AzJester/passive_sensor_demo_F5.2/docs/images/demo/hardware_exploded.png

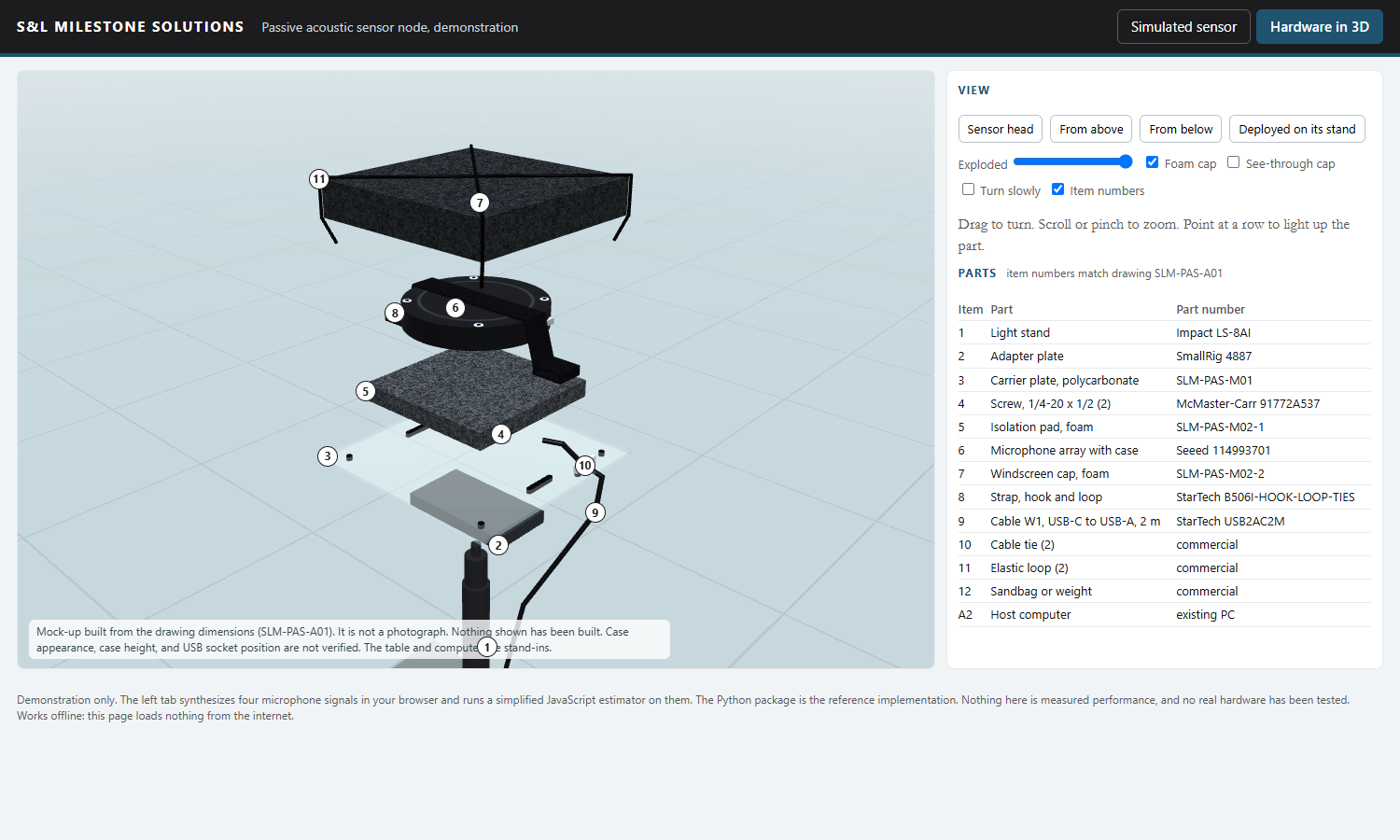
docs/images/demo/hardware_exploded.png
