AzJester/passive_sensor_demo_F5.2/docs/images/demo/hardware_from_above.png

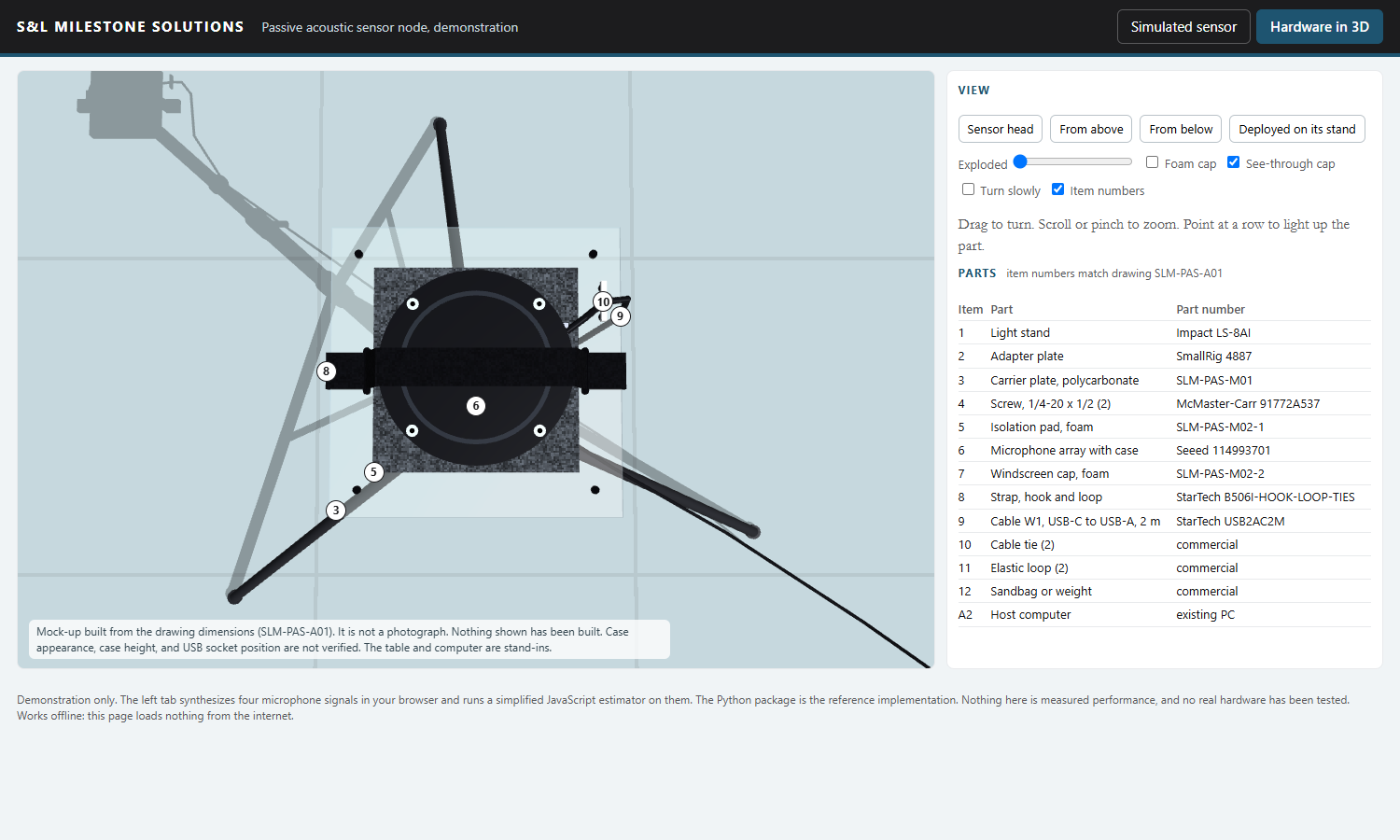
docs/images/demo/hardware_from_above.png
