AzJester/passive_sensor_demo_F5.2/docs/images/demo/sensor_false_alert_source.png

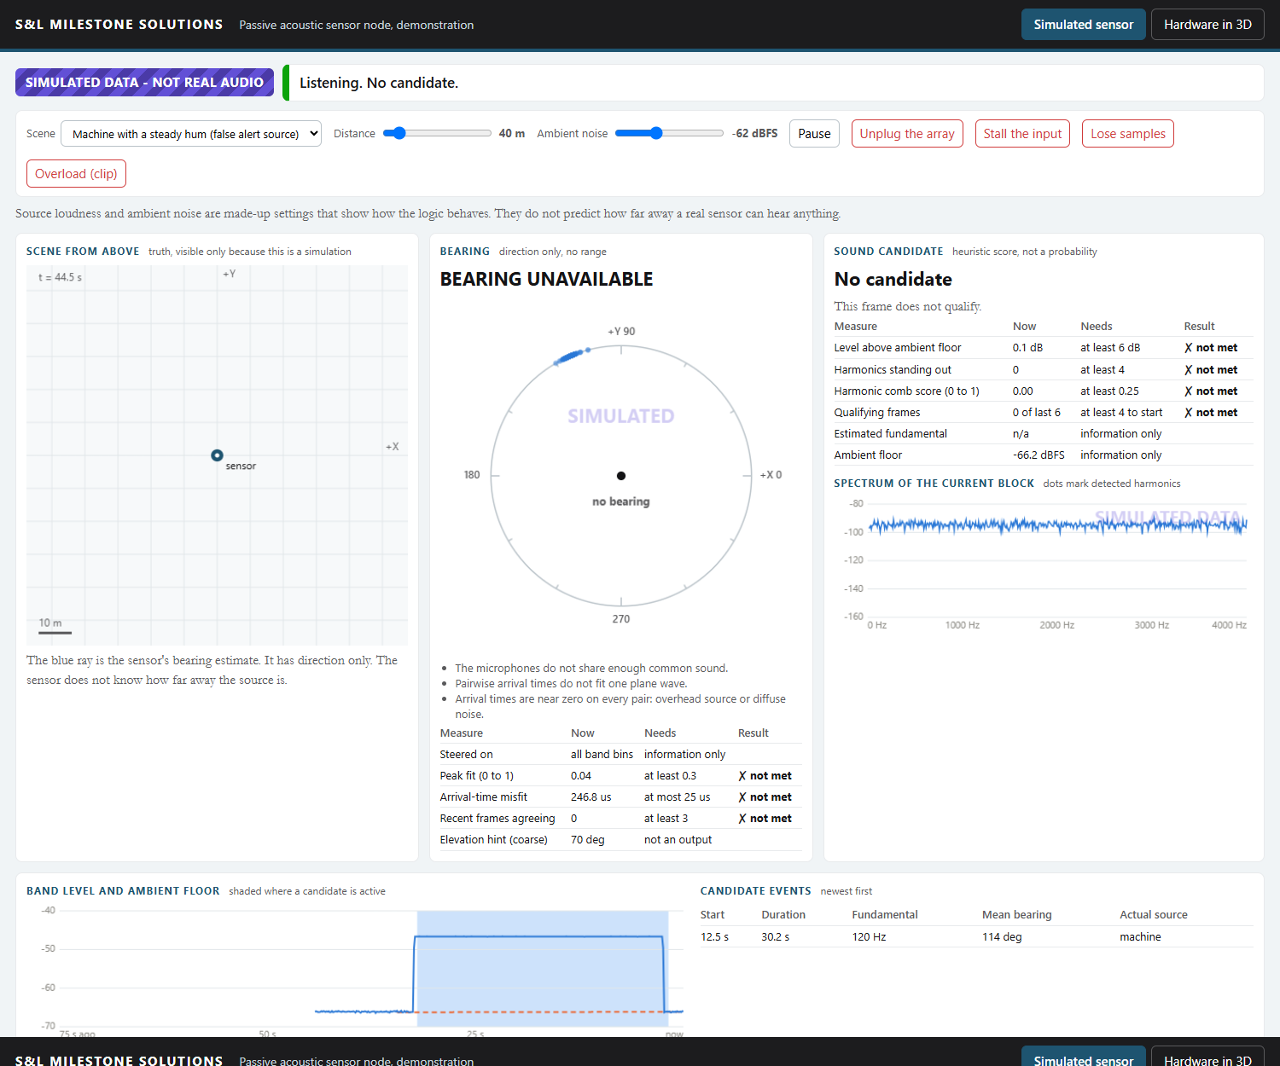
docs/images/demo/sensor_false_alert_source.png
