AzJester/passive_sensor_demo_F5.2/docs/images/demo/sensor_input_stale.png

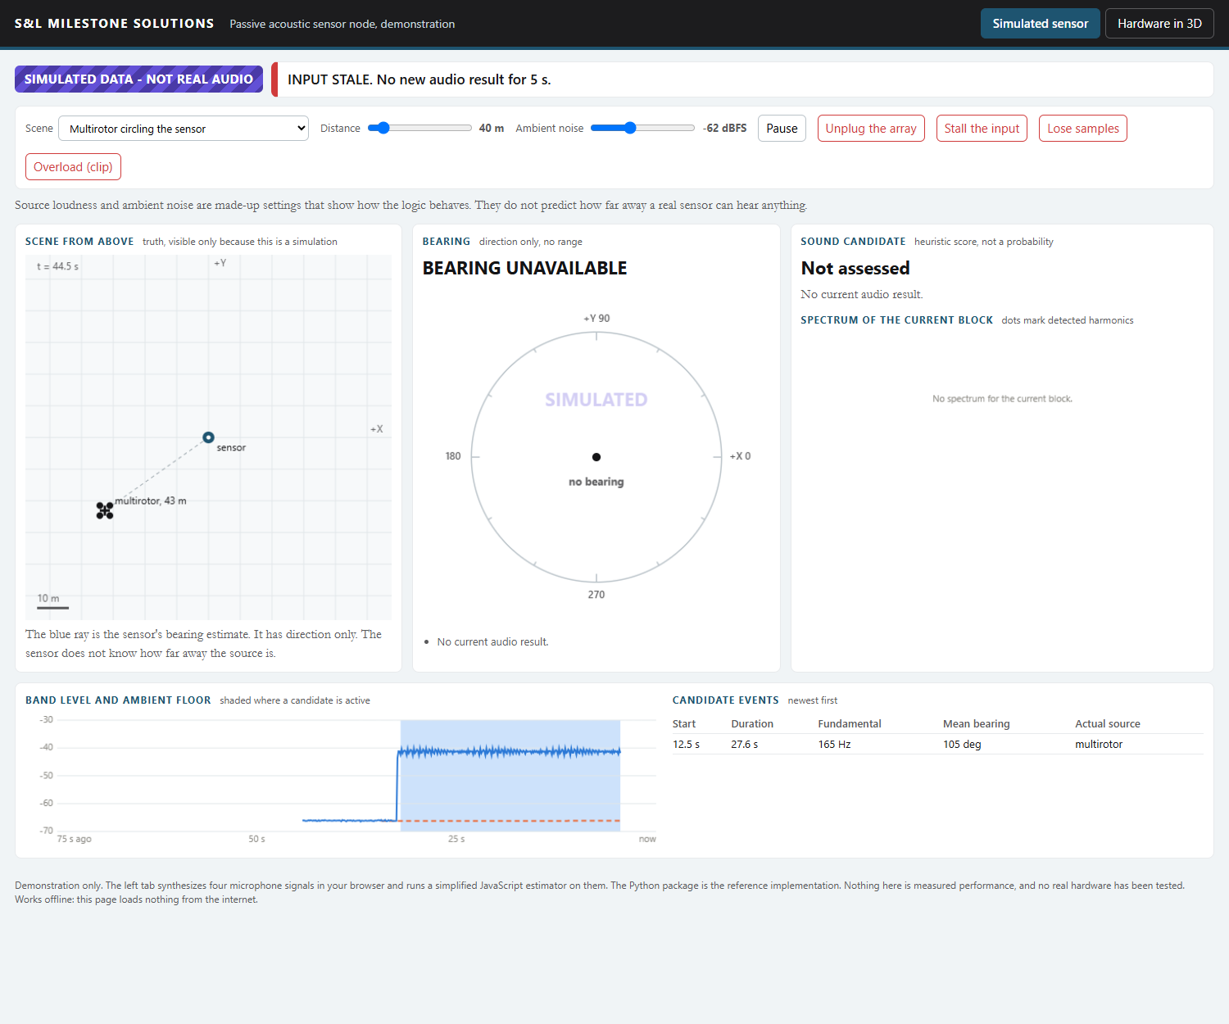
docs/images/demo/sensor_input_stale.png
