AzJester/passive_sensor_demo_F5.2/docs/images/demo/sensor_tone_rejected.png

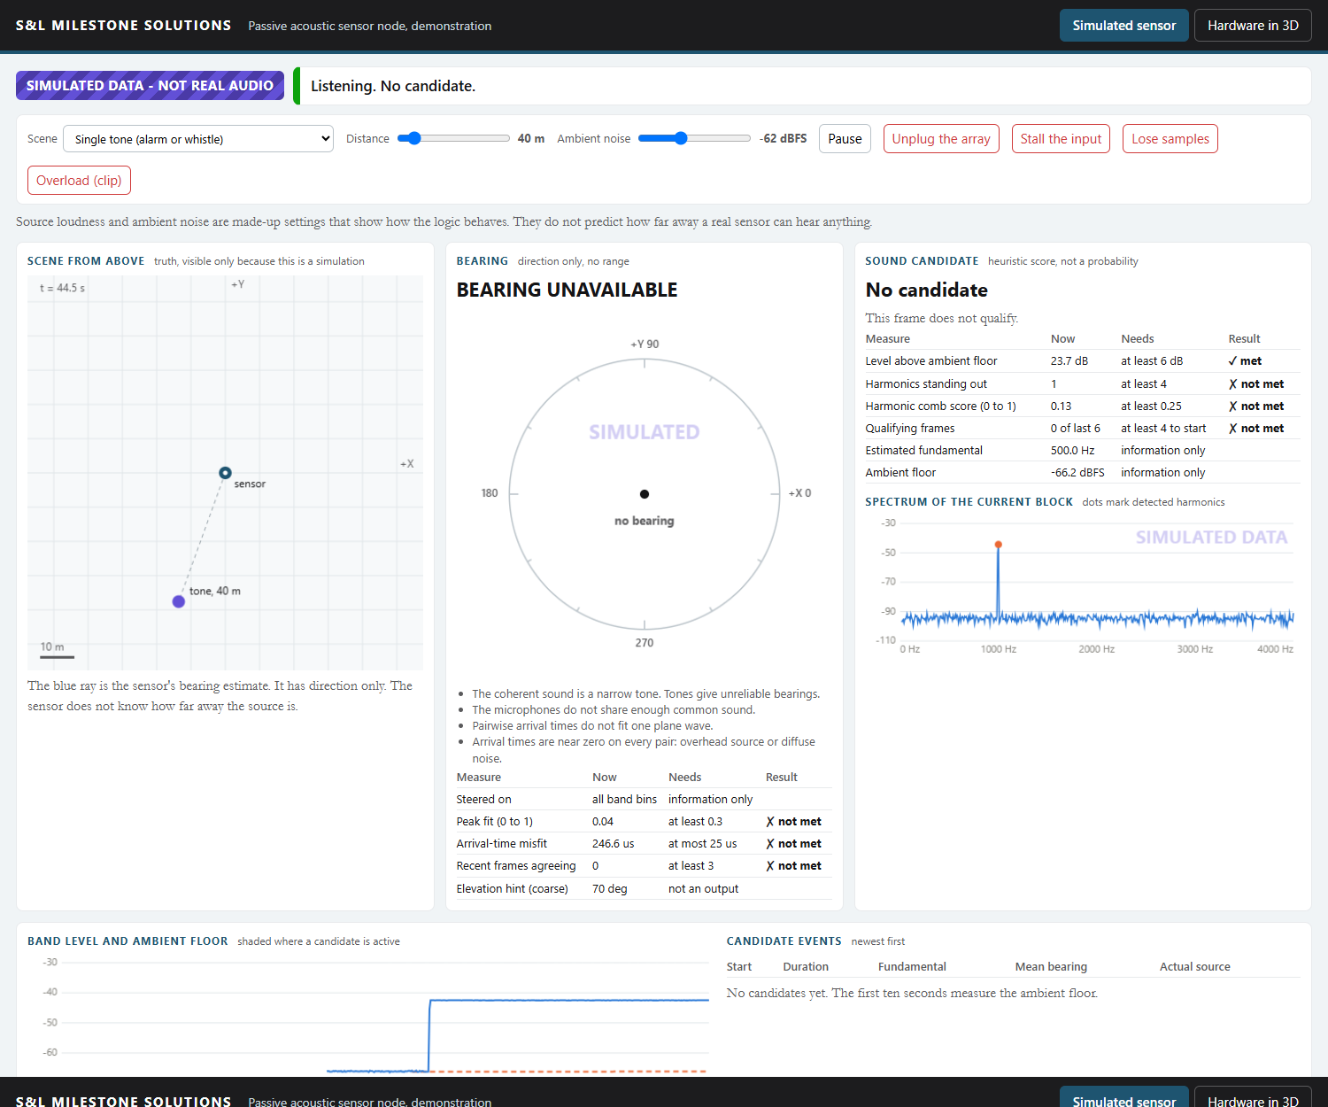
docs/images/demo/sensor_tone_rejected.png
