AzJester/passive_sensor_demo_F5.2/hardware/bom.csv

ref | group | item | manufacturer | part_number | quantity | unit_price_usd | price_seen | price_date | source | url | note
A1 | required | USB four-microphone array with case | Seeed Studio | 114993701 | 1 | 59.90 | page | 2026-11-09 | Seeed Studio | https://www.seeedstudio.com/ReSpeaker-XVF3800-USB-4-Mic-Array-With-Case-p-6490.html | China warehouse in stock; US on back order; Mouser 713-114993701
W1 | required | USB 2.0 cable, USB-C to USB-A, 2 m | StarTech | USB2AC2M | 1 | 20.49 | page | 2026-11-09 | StarTech | https://www.startech.com/en-us/cables/usb2ac2m | USB-C host: USB2CC1M
P1 | required | Clear polycarbonate sheet, 12 x 12 x 1/8 in | McMaster-Carr | 8574K26 | 1 | 10.42 | page | 2026-11-09 | McMaster-Carr | https://www.mcmaster.com/8574K26/ | carrier plate M01
M1 | required | Tripod adapter plate with 1/4 in-20 threads | SmallRig | 4887 | 1 | 12.99 | page | 2026-11-09 | B&H | https://www.bhphotovideo.com/c/product/1852171-REG/smallrig_4887_multifunctional_cheese_mount_plate.html | hole spacing not verified
M2 | required | Screw 1/4 in-20 x 1/2 in, 18-8, pack of 50 | McMaster-Carr | 91772A537 | 1 | 14.80 | page | 2026-11-09 | McMaster-Carr | https://www.mcmaster.com/91772A537/ | 2 used
M3 | required | Light stand with 1/4 in-20 stud | Impact | LS-8AI | 1 | 32.95 | page | 2026-11-09 | B&H | https://www.bhphotovideo.com/c/product/1258466-REG/impact_ls_8ai_air_cushioned_light_stand_black.html | weight the base
M4 | required | Hook-and-loop ties, 6 in, pack of 50 | StarTech | B506I-HOOK-LOOP-TIES | 1 | 19.46 | page | 2026-11-09 | StarTech | https://www.startech.com/en-us/cables/b506i-hook-loop-ties | join three end to end
M5 | required | Reticulated polyurethane foam, 30 PPI, 1 in x 36 x 48 in | The Foam Factory | no SKU shown | 1 | 24.99 | page | 2026-11-09 | The Foam Factory | https://www.thefoamfactory.com/opencellfoam/filter.html | windscreen cap
M6 | required | Reticulated polyurethane foam, 30 PPI, 1/2 in x 36 x 48 in | The Foam Factory | no SKU shown | 1 | 12.99 | page | 2026-11-09 | The Foam Factory | https://www.thefoamfactory.com/opencellfoam/filter.html | isolation pad
F1 | optional | Snap-on ferrite, 6.6 mm bore | Fair-Rite | 0431164281 | 1 | 2.83 | page | 2026-11-09 | Digi-Key | https://www.digikey.com/en/products/detail/fair-rite-products-corp/0431164281/8594000 | only if interference is seen
M7 | optional | Screw M4 x 20, pan head, 18-8, pack of 100 | McMaster-Carr | 92000A228 | 1 | 14.76 | page | 2026-11-09 | McMaster-Carr | https://www.mcmaster.com/92000A228/ | corner holes
M8 | optional | Locknut M4, nylon insert, 18-8, pack of 100 | McMaster-Carr | 93625A150 | 1 | 7.03 | page | 2026-11-09 | McMaster-Carr | https://www.mcmaster.com/93625A150/ | corner holes
M9 | optional | Washer M4, 18-8, pack of 100 | McMaster-Carr | 93475A230 | 1 | 3.93 | page | 2026-11-09 | McMaster-Carr | https://www.mcmaster.com/93475A230/ | corner holes
M10 | optional | Adhesive cable-tie mount, 1 x 1 in | Panduit | ABM2S-A-C | 2 | 1.07 | search excerpt | 2026-11-09 | Gordon Electric Supply | https://www.gordonelectricsupply.com/p/Panduit-Abm2S-A-C-Cable-Tie-Mount-Adh-1Inxi1In-Wh-Pk100/6750617 | strain relief on the stand
T1 | test equipment | Battery loudspeaker | JBL | JBLGO5BLUAM | 1 | 54.95 | page | 2026-11-09 | B&H | https://www.bhphotovideo.com/c/product/1808908-REG/jbl_jblgo4bluam_go_4_portable_bluetooth.html | broadband test source
T2 | test equipment | Tape measure, 100 ft, open reel | Komelon | 6611 | 1 | 25.67 | search excerpt | 2026-11-09 | Hanes Supply | https://www.hanessupply.com/hand-tools/testing-and-measuring/komelon-6611 | positions
T3 | test equipment | Thermometer and hygrometer | ThermoPro | TP50 | 1 | 15.99 | search excerpt | 2026-11-09 | TempPro | https://temppro.com/products/tp50-digital-indoor-hygrometer-thermometer | air temperature
T4 | test equipment | Sound level meter | Galaxy Audio | CM-130 | 1 | 74.99 | page | 2026-11-09 | B&H | https://www.bhphotovideo.com/c/product/333306-REG/Galaxy_Audio_CM_130_CM_130_CHECK_MATE.html | optional
