AzJester/passive_sensor_demo_F5.2/hardware/cad/carrier.dxf

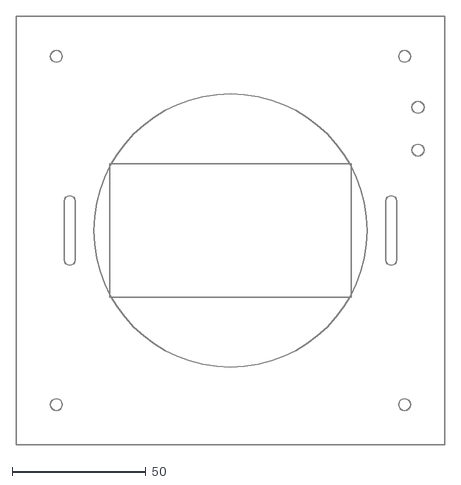
[picture p13: CAD file, 2026-11-10]
hardware/cad/carrier.dxf
160.0 x 160.0
