AzJester/passive_sensor_demo_F5.2/hardware/cad/carrier.scad

// Carrier plate SLM-PAS-M01, revision A, 2026-11-10. Millimetres. Generated by hardware/make_cad.py.
// S&L Milestone Solutions. Preliminary: not cut or fitted. Measure the purchased case before cutting.
$fn = 64;
plate_side = 160.0;
plate_thickness = 3.0;

module slot(x, y, w, len) {
    hull() {
        translate([x, y - (len - w) / 2, -1]) cylinder(h = plate_thickness + 2, d = w);
        translate([x, y + (len - w) / 2, -1]) cylinder(h = plate_thickness + 2, d = w);
    }
}

difference() {
    cube([plate_side, plate_side, plate_thickness]);
    translate([15.0, 15.0, -1]) cylinder(h = plate_thickness + 2, d = 4.5);
    translate([145.0, 15.0, -1]) cylinder(h = plate_thickness + 2, d = 4.5);
    translate([15.0, 145.0, -1]) cylinder(h = plate_thickness + 2, d = 4.5);
    translate([145.0, 145.0, -1]) cylinder(h = plate_thickness + 2, d = 4.5);
    translate([150.0, 110.0, -1]) cylinder(h = plate_thickness + 2, d = 4.5);
    translate([150.0, 126.0, -1]) cylinder(h = plate_thickness + 2, d = 4.5);
    slot(20.0, 80.0, 4.0, 26.0);
    slot(140.0, 80.0, 4.0, 26.0);
}

// Reference only: listed case outline. Remove before export.
%translate([plate_side / 2, plate_side / 2, plate_thickness + 10]) cylinder(h = 10, d = 102.0);
