AzJester/passive_sensor_demo_F5.2/hardware/drawings/SLM-PAS-A01.pdf

## TOP VIEW

6

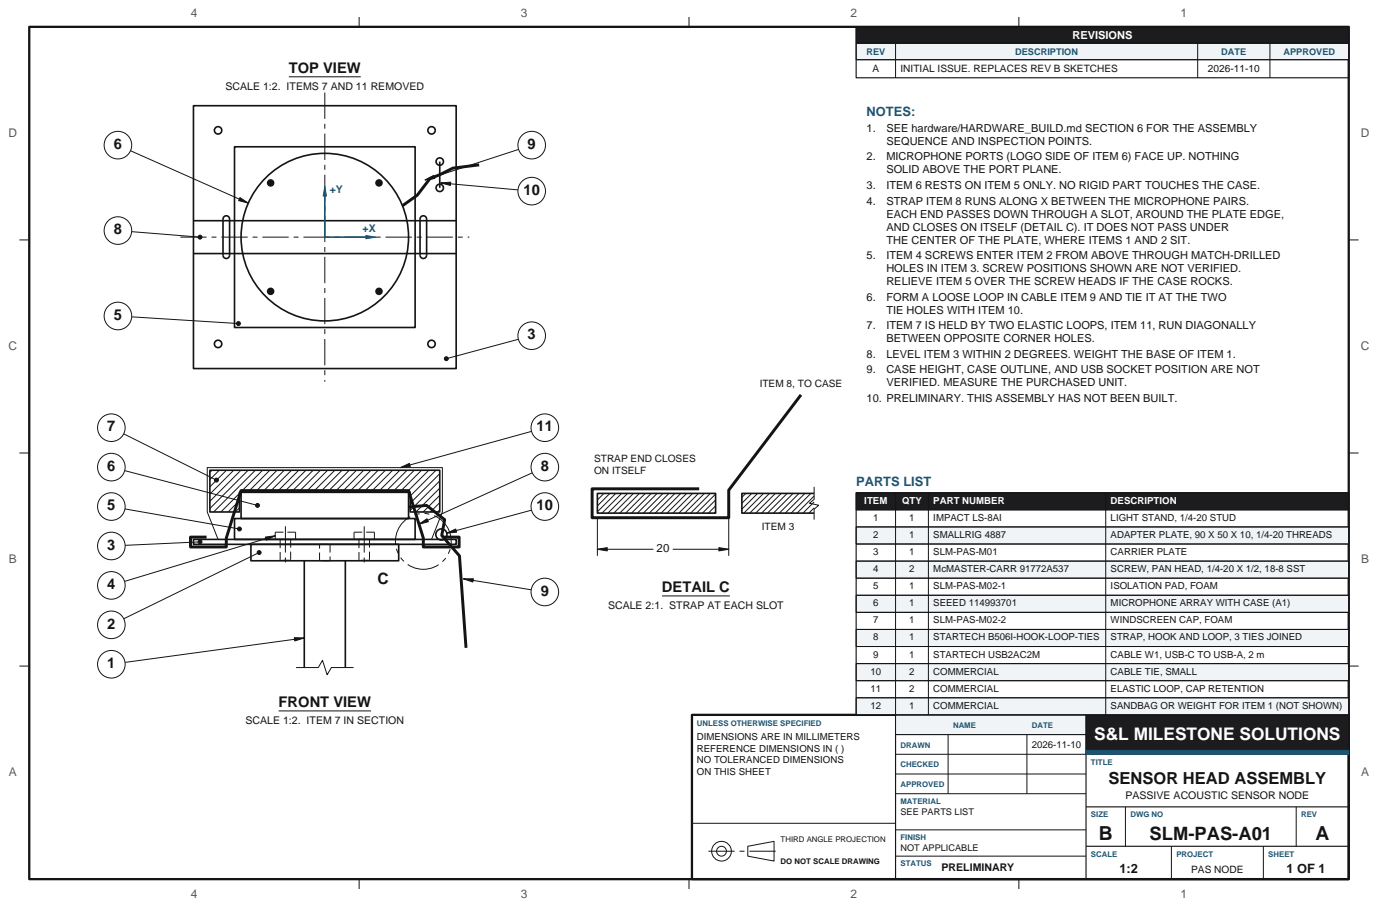
[picture p16: page 1]
REVISIONS; REV; DESCRIPTION; DATE; APPROVED; INITIAL ISSUE. REPLACES REV B SKETCHES; NAME; FINISH NOT APPLICABLE STATUS PRELIMINARY; S&L MILESTONE SOLUTIONS; SIZE; DWG NO; REV A; SCALE; PROJECT PAS NODE; SHEET 1 OF 1; ITEM 3; DETAIL C; PARTS LIST; ITEM; QTY; PART NUMBER; IMPACT LS-8AI; LIGHT STAND, 1/4-20 STUD; SMALLRIG 4887; ADAPTER PLATE, 90 X 50 X 10, 1/4-20 THREADS; SLM-PAS-M01; CARRIER PLATE; McMASTER-CARR 91772A537; SCREW, PAN HEAD, 1/4-20 X 1/2, 18-8 SST; SLM-PAS-M02-1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

SCALE 1:2. ITEMS 7 AND 11 REMOVED

NOTES:
1. SEE hardware/HARDWARE_BUILD.md SECTION 6 FOR THE ASSEMBLY
SEQUENCE AND INSPECTION POINTS.
2. MICROPHONE PORTS (LOGO SIDE OF ITEM 6) FACE UP. NOTHING
SOLID ABOVE THE PORT PLANE.
3. ITEM 6 RESTS ON ITEM 5 ONLY. NO RIGID PART TOUCHES THE CASE.
4. STRAP ITEM 8 RUNS ALONG X BETWEEN THE MICROPHONE PAIRS.
EACH END PASSES DOWN THROUGH A SLOT, AROUND THE PLATE EDGE,
AND CLOSES ON ITSELF (DETAIL C). IT DOES NOT PASS UNDER
THE CENTER OF THE PLATE, WHERE ITEMS 1 AND 2 SIT.
5. ITEM 4 SCREWS ENTER ITEM 2 FROM ABOVE THROUGH MATCH-DRILLED
HOLES IN ITEM 3. SCREW POSITIONS SHOWN ARE NOT VERIFIED.
RELIEVE ITEM 5 OVER THE SCREW HEADS IF THE CASE ROCKS.
6. FORM A LOOSE LOOP IN CABLE ITEM 9 AND TIE IT AT THE TWO
TIE HOLES WITH ITEM 10.
7. ITEM 7 IS HELD BY TWO ELASTIC LOOPS, ITEM 11, RUN DIAGONALLY
BETWEEN OPPOSITE CORNER HOLES.
8. LEVEL ITEM 3 WITHIN 2 DEGREES. WEIGHT THE BASE OF ITEM 1.
9. CASE HEIGHT, CASE OUTLINE, AND USB SOCKET POSITION ARE NOT
VERIFIED. MEASURE THE PURCHASED UNIT.
10. PRELIMINARY. THIS ASSEMBLY HAS NOT BEEN BUILT.

ITEM 8, TO CASE

STRAP END CLOSES
ON ITSELF

SCALE 2:1. STRAP AT EACH SLOT

FRONT VIEW
SCALE 1:2. ITEM 7 IN SECTION

UNLESS OTHERWISE SPECIFIED
DIMENSIONS ARE IN MILLIMETERS
REFERENCE DIMENSIONS IN ( )
NO TOLERANCED DIMENSIONS
ON THIS SHEET

DRAWN | 2026-11-10

TITLE
SENSOR HEAD ASSEMBLY
PASSIVE ACOUSTIC SENSOR NODE
SLM-PAS-A01

CHECKED

APPROVED

MATERIAL
SEE PARTS LIST

THIRD ANGLE PROJECTION

DO NOT SCALE DRAWING
