AzJester/passive_sensor_demo_F5.2/(commit log)

2026-11-10 Passive acoustic UAS sensor prototype, Revision B, release 0.2.2
    Design package for a passive acoustic sensor node: requirements, bill of
    materials, engineering drawings, firmware setup procedure, sensor software
    with tests, test procedures, a simulated demo page, and the verification
    record. No hardware has been bought, built, or tested.
    Also adds the executive brief (PDF), a GitHub Pages workflow that publishes
    the demo folder, and a .gitattributes rule that keeps files byte for byte so
    SHA256SUMS.txt matches after a clone.
    [bom.csv, carrier.dxf, carrier.scad, dataset_manifest_template.csv]
2026-11-10 Release 0.2.3: public demo address at the top of the README
    The sensor software, the drawing set, and the demonstration page are
    unchanged. The README now opens with the public demo address. The dashboard
    test client picks its own source port when Windows has no free outgoing
    port, and the executive brief folder is left out of the release archive.
